anhenaobe/Sonometro/(commit log)

2026-10-24 docs: initialize single-channel IEPE sonometer project
    [bom.csv]
2026-10-28 docs: add LTspice simulation of LT3092 IEPE current source
    Simulate the LT3092 (ADI, as in CN0540) feeding the ROGA RG-50 with
    LTspice 26 driven from Python via spicelib: supply compliance, large
    signal at 130 dB peak, supply ripple, source noise with CSET and
    power-up through the AC coupling.
    Results (simulation only, pending bench test T1): 24 V supply gives
    6.4 V margin over the 130 dB peak; 0.46 uV noise with CSET = 100 nF
    versus a 41 uV microphone floor; 12.7 V power-up step toward the ADC
    requires protection. Proposed RSET 20k, ROUT 71.5 (2.8 mA).
    Adds the markdown write-up with limitations and next steps, a compact
    LaTeX/PDF report for submission, and links the result from decisions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
